bradyte/minimax/hardware/minimax.png

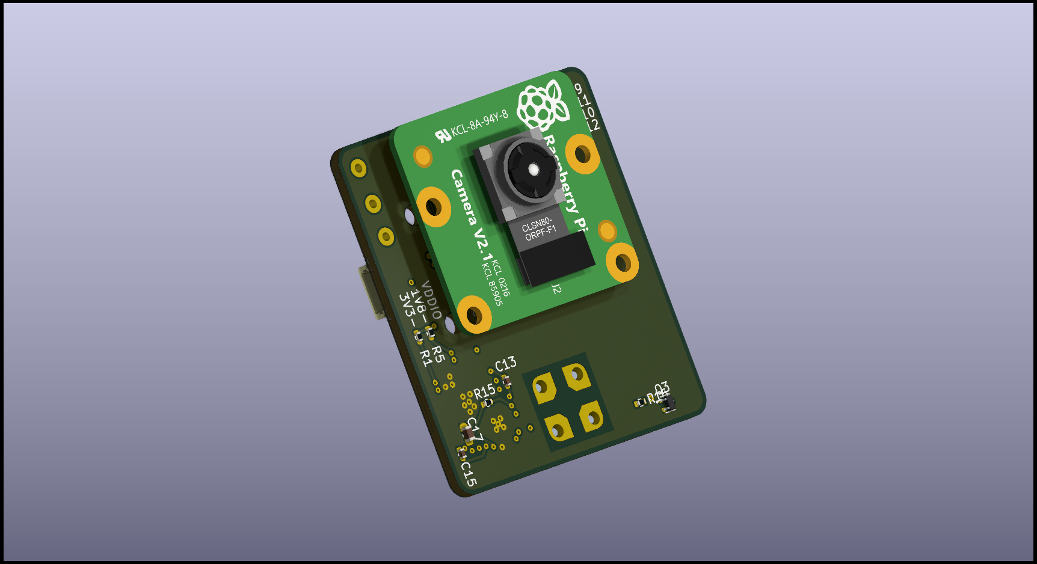
hardware/minimax.png
