bradyte/minimax/hardware/minimax-front.png

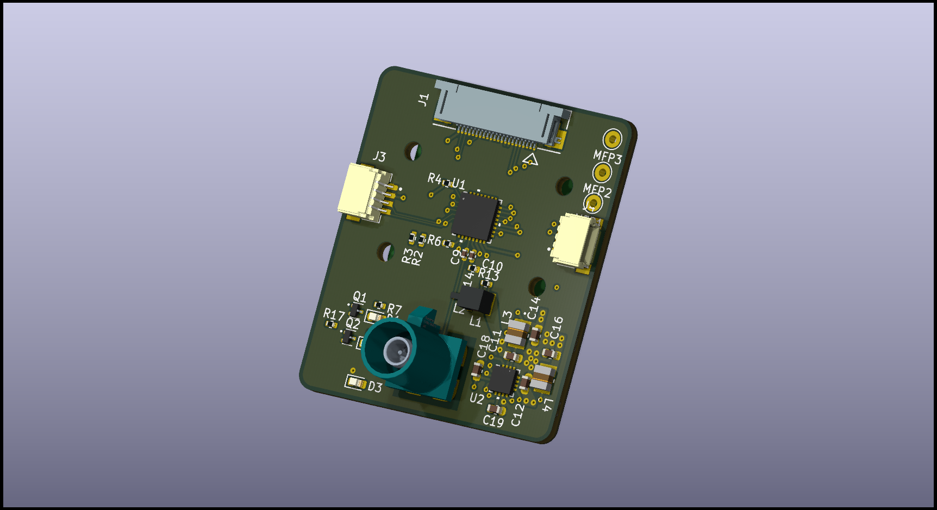
hardware/minimax-front.png
