bradyte/minimax/hardware/minimax.kicad_pcb

## KiCad design hardware/minimax.kicad_pcb (2025-03-13)

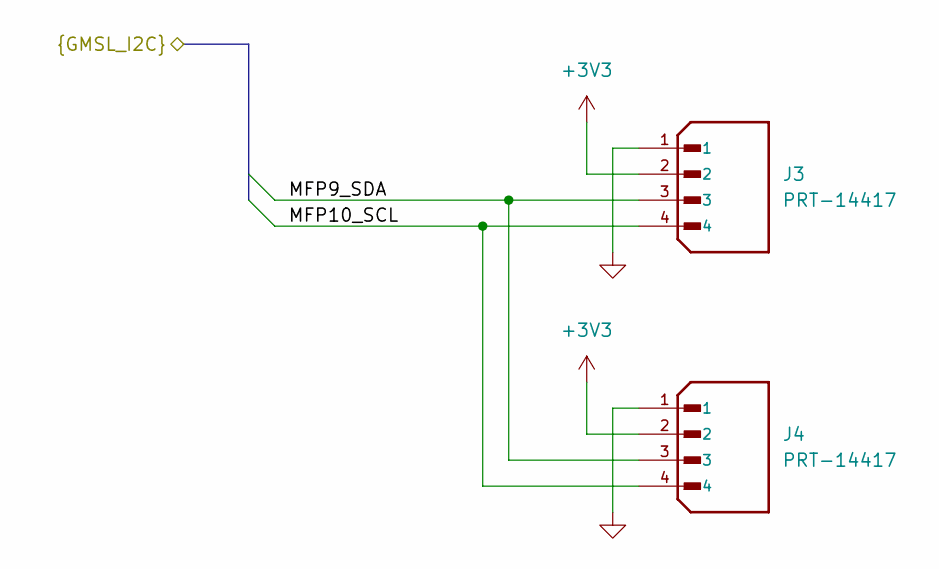
[picture p9: schematic peripherals.kicad_sch]

Parts:
J3, J4: PRT-14417; SPARKFUN_PRT-14417

Connections:
+3V3: J3.2, J4.2; also elsewhere on the board
/camera/MFP9_SDA: J3.3, J4.3; also elsewhere on the board
/camera/MFP10_SCL: J3.4, J4.4; also elsewhere on the board
GND: J3.1, J4.1; also elsewhere on the board

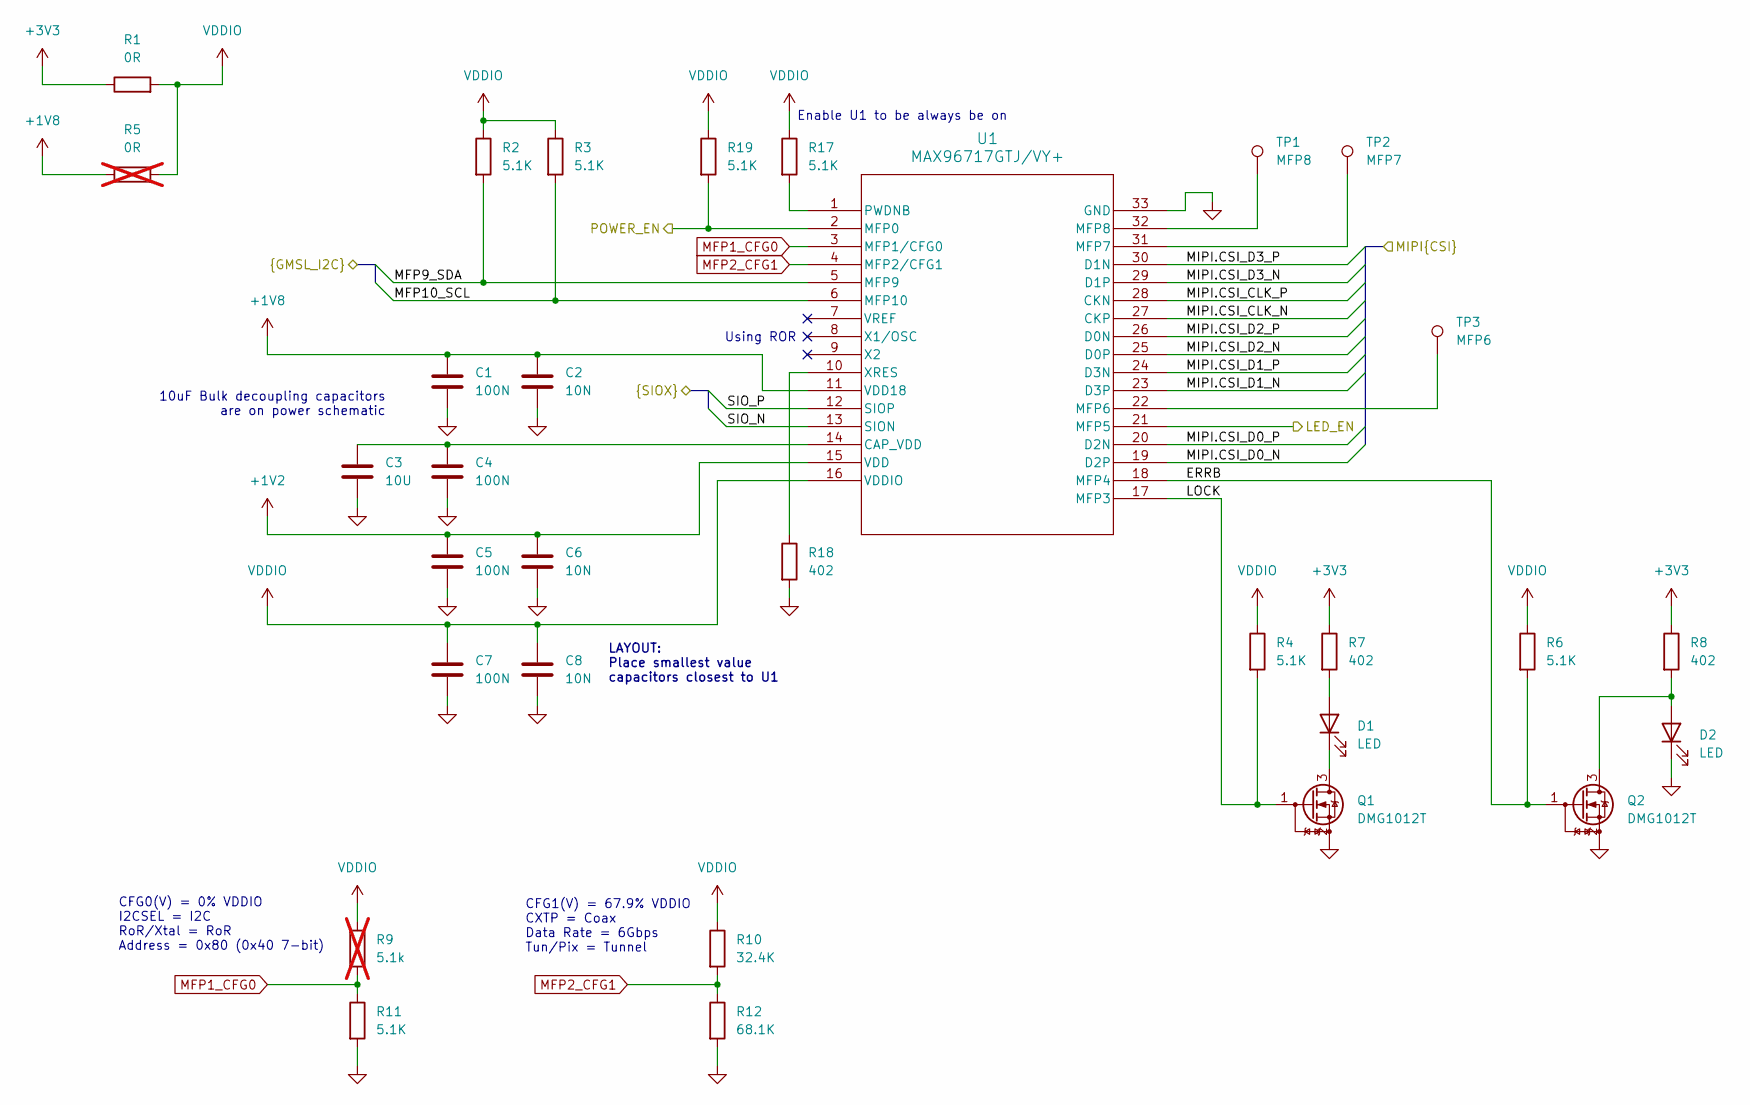
[picture p10: schematic gmsl.kicad_sch]

Parts:
C1, C4, C5, C7: 100N; C_0402_1005Metric
C2, C6, C8: 10N; C_0402_1005Metric
C3: 10U; C_0603_1608Metric
D1, D2: LED; LED_0603_1608Metric
Q1, Q2: DMG1012T; SOT-523
R1: 0R; R_0402_1005Metric
R2, R3, R4, R6, R11, R17, R19: 5.1K; R_0402_1005Metric
R5: 0R; R_0402_1005Metric; not fitted
R7, R8, R18: 402; R_0402_1005Metric
R9: 5.1k; R_0402_1005Metric; not fitted
R10: 32.4K; R_0402_1005Metric
R12: 68.1K; R_0402_1005Metric
TP1: MFP8; TestPoint_THTPad_D1.0mm_Drill0.5mm
TP2: MFP7; TestPoint_THTPad_D1.0mm_Drill0.5mm
TP3: MFP6; TestPoint_THTPad_D1.0mm_Drill0.5mm
U1: MAX96717GTJ/VY+; ADI_21-100156_T3255Y-8

Connections:
+1V2: C5.1, C6.1, U1.15 (VDD); also elsewhere on the board
+1V8: C1.1, C2.1, R5.1, U1.11 (VDD18); also elsewhere on the board
+3V3: R1.1, R7.1, R8.1; also elsewhere on the board
/camera/LED_EN: U1.21 (MFP5); also elsewhere on the board
/camera/MFP9_SDA: R2.2, U1.5 (MFP9); also elsewhere on the board
/camera/MFP10_SCL: R3.2, U1.6 (MFP10); also elsewhere on the board
/camera/MIPI.CSI_CLK_N: U1.27 (CKP); also elsewhere on the board
/camera/MIPI.CSI_CLK_P: U1.28 (CKN); also elsewhere on the board
/camera/MIPI.CSI_D0_N: U1.19 (D2P); also elsewhere on the board
/camera/MIPI.CSI_D0_P: U1.20 (D2N); also elsewhere on the board
/camera/MIPI.CSI_D1_N: U1.23 (D3P); also elsewhere on the board
/camera/MIPI.CSI_D1_P: U1.24 (D3N); also elsewhere on the board
/camera/MIPI.CSI_D2_N: U1.25 (D0P); also elsewhere on the board
/camera/MIPI.CSI_D2_P: U1.26 (D0N); also elsewhere on the board
/camera/MIPI.CSI_D3_N: U1.29 (D1P); also elsewhere on the board
/camera/MIPI.CSI_D3_P: U1.30 (D1N); also elsewhere on the board
/camera/POWER_EN: R19.2, U1.2 (MFP0); also elsewhere on the board
/connector/SIO_N: U1.13 (SION); also elsewhere on the board
/connector/SIO_P: U1.12 (SIOP); also elsewhere on the board
/gmsl/ERRB: Q2.1 (G), R6.2, U1.18 (MFP4)
/gmsl/LOCK: Q1.1 (G), R4.2, U1.17 (MFP3)
GND: C1.2, C2.2, C3.2, C4.2, C5.2, C6.2, C7.2, C8.2, D2.1 (K), Q1.2 (S), Q2.2 (S), R11.2, R12.2, R18.2, U1.33 (GND); also elsewhere on the board
MFP1_CFG0: R9.2, R11.1, U1.3 (MFP1/CFG0)
MFP2_CFG1: R10.2, R12.1, U1.4 (MFP2/CFG1)
unnamed: D1.2 (A), R7.2
unnamed: D1.1 (K), Q1.3 (D)
unnamed: D2.2 (A), Q2.3 (D), R8.2
unnamed: C3.1, C4.1, U1.14 (CAP_VDD)
unnamed: TP3.1, U1.22 (MFP6)
unnamed: TP2.1, U1.31 (MFP7)
unnamed: TP1.1, U1.32 (MFP8)
unnamed: R17.2, U1.1 (PWDNB)
unnamed: R18.1, U1.10 (XRES)
VDDIO: C7.1, C8.1, R1.2, R2.1, R3.1, R4.1, R5.2, R6.1, R9.1, R10.1, R17.1, R19.1, U1.16 (VDDIO)

Notes on the sheet:
LAYOUT: Place smallest value capacitors closest to U1
CFG0(V) = 0% VDDIO I2CSEL = I2C RoR/Xtal = RoR Address = 0x80 (0x40 7-bit)
10uF Bulk decoupling capacitors are on power schematic
Using ROR
CFG1(V) = 67.9% VDDIO CXTP = Coax Data Rate = 6Gbps Tun/Pix = Tunnel
Enable U1 to be always be on

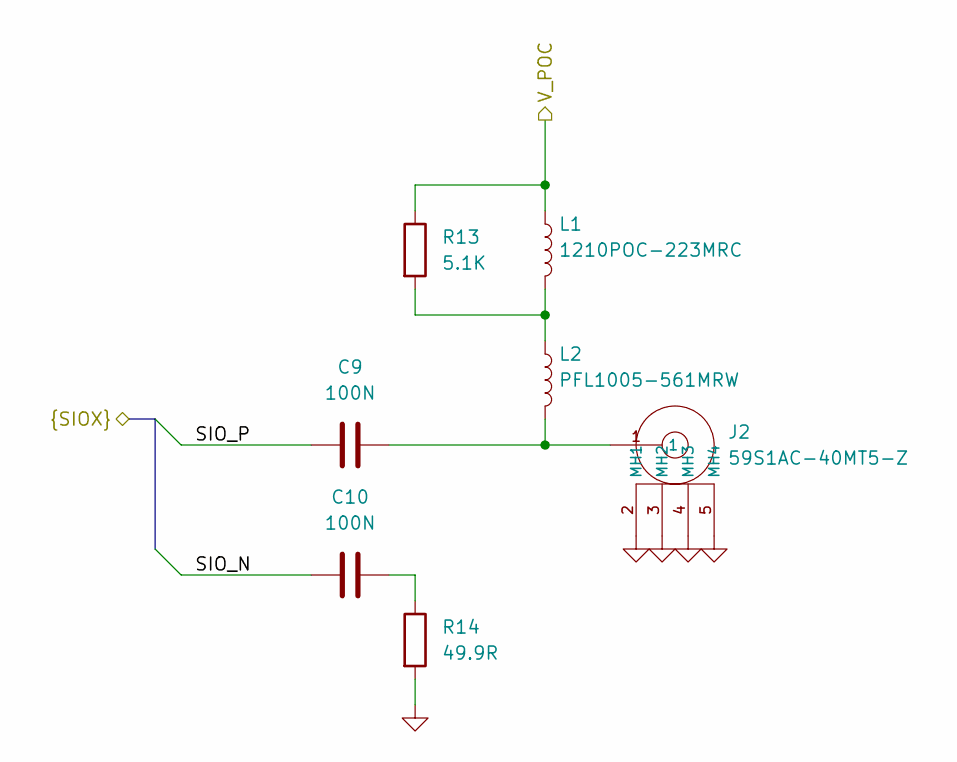
[picture p11: schematic connector.kicad_sch]

Parts:
C9, C10: 100N; C_0402_1005Metric
J2: 59S1AC-40MT5-Z
L1: 1210POC-223MRC; L_Coilcraft_1210POC
L2: PFL1005-561MRW; L_Coilcraft_PFL1005
R13: 5.1K; R_0402_1005Metric
R14: 49.9R; R_0402_1005Metric

Connections:
/connector/SIO_N: C10.1; also elsewhere on the board
/connector/SIO_P: C9.1; also elsewhere on the board
/connector/V_POC: L1.1, R13.1; also elsewhere on the board
GND: J2.2 (MH1), J2.3 (MH2), J2.4 (MH3), J2.5 (MH4), R14.2; also elsewhere on the board
unnamed: C9.2, J2.1, L2.2
unnamed: C10.2, R14.1
unnamed: L1.2, L2.1, R13.2

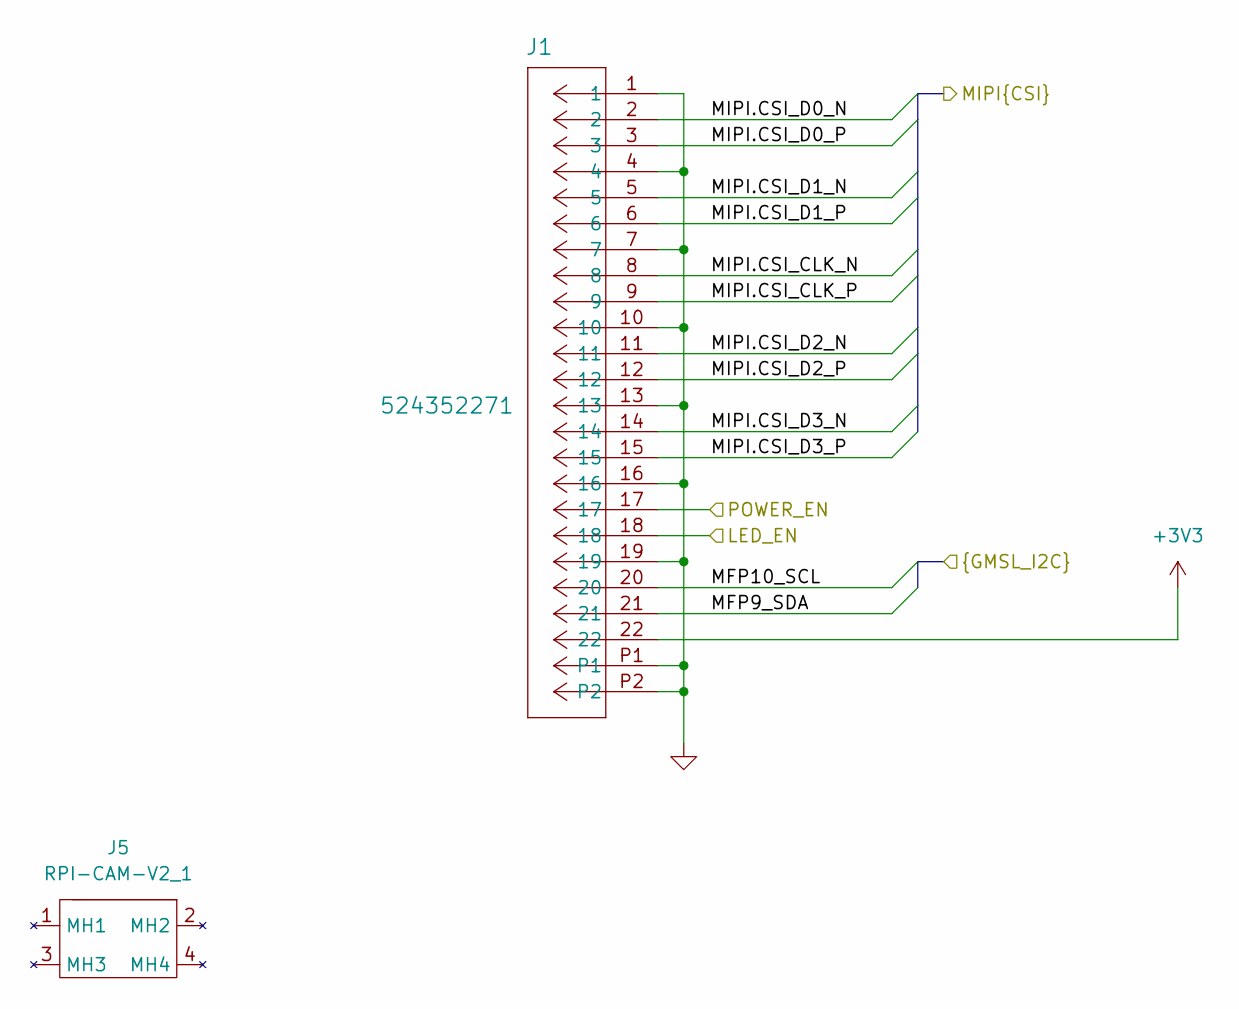
[picture p12: schematic camera.kicad_sch]

Parts:
J1: 524352271; CON_524352271_MOL
J5: RPI-CAM-V2_1

Connections:
+3V3: J1.22; also elsewhere on the board
/camera/LED_EN: J1.18; also elsewhere on the board
/camera/MFP9_SDA: J1.21; also elsewhere on the board
/camera/MFP10_SCL: J1.20; also elsewhere on the board
/camera/MIPI.CSI_CLK_N: J1.8; also elsewhere on the board
/camera/MIPI.CSI_CLK_P: J1.9; also elsewhere on the board
/camera/MIPI.CSI_D0_N: J1.2; also elsewhere on the board
/camera/MIPI.CSI_D0_P: J1.3; also elsewhere on the board
/camera/MIPI.CSI_D1_N: J1.5; also elsewhere on the board
/camera/MIPI.CSI_D1_P: J1.6; also elsewhere on the board
/camera/MIPI.CSI_D2_N: J1.11; also elsewhere on the board
/camera/MIPI.CSI_D2_P: J1.12; also elsewhere on the board
/camera/MIPI.CSI_D3_N: J1.14; also elsewhere on the board
/camera/MIPI.CSI_D3_P: J1.15; also elsewhere on the board
/camera/POWER_EN: J1.17; also elsewhere on the board
GND: J1.1, J1.4, J1.7, J1.10, J1.13, J1.16, J1.19, J1.P1, J1.P2; also elsewhere on the board

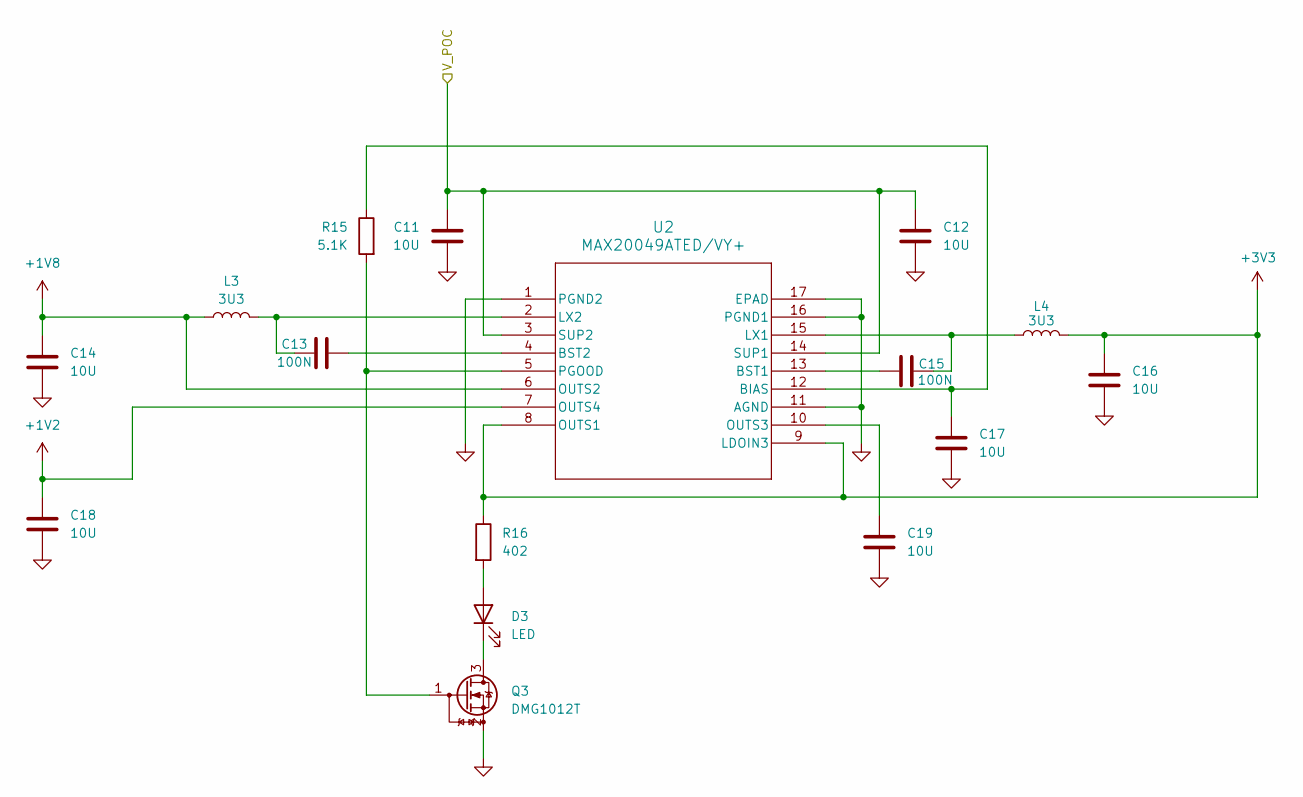
[picture p13: schematic power.kicad_sch]

Parts:
C11, C12, C14, C16, C17, C18, C19: 10U; C_0603_1608Metric
C13, C15: 100N; C_0402_1005Metric
D3: LED; LED_0603_1608Metric
L3, L4: 3U3; IND_TFM252012ALMA_TDK
Q3: DMG1012T; SOT-523
R15: 5.1K; R_0402_1005Metric
R16: 402; R_0402_1005Metric
U2: MAX20049ATED/VY+; 21-100150D_T1633Y&plus_5C_MXM

Connections:
+1V2: C18.1, U2.7 (OUTS4); also elsewhere on the board
+1V8: C14.1, L3.1, U2.6 (OUTS2); also elsewhere on the board
+3V3: C16.1, L4.1, R16.1, U2.8 (OUTS1), U2.9 (LDOIN3); also elsewhere on the board
/connector/V_POC: C11.1, C12.1, U2.3 (SUP2), U2.14 (SUP1); also elsewhere on the board
GND: C11.2, C12.2, C14.2, C16.2, C17.2, C18.2, C19.2, Q3.2 (S), U2.1 (PGND2), U2.11 (AGND), U2.16 (PGND1), U2.17 (EPAD); also elsewhere on the board
unnamed: D3.2 (A), R16.2
unnamed: D3.1 (K), Q3.3 (D)
unnamed: Q3.1 (G), R15.2, U2.5 (PGOOD)
unnamed: C17.1, R15.1, U2.12 (BIAS)
unnamed: C15.1, U2.13 (BST1)
unnamed: C13.2, U2.4 (BST2)
unnamed: C15.2, L4.2, U2.15 (LX1)
unnamed: C13.1, L3.2, U2.2 (LX2)
unnamed: C19.1, U2.10 (OUTS3)

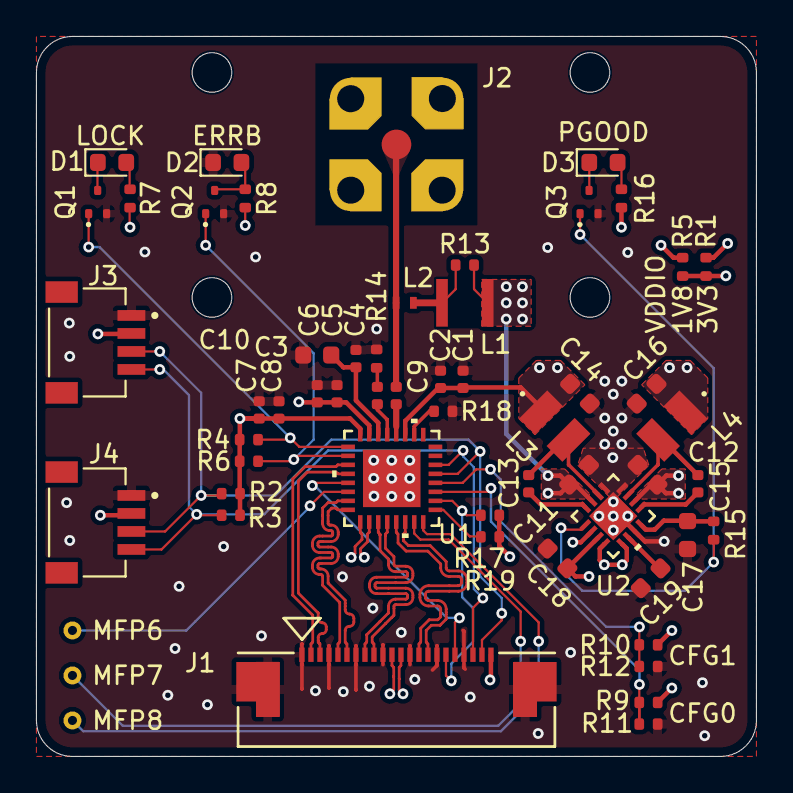
[picture p14: board minimax.kicad_pcb from above]

Board: 4 copper layers, 40.0 x 40.0 mm, 58 parts (0 on the bottom side), 47 nets.
