bradyte/minimax/(commit log)

2024-09-18 initial upload
    [minimax.kicad_pcb, minimax.kicad_sch]
2024-09-19 mipi interface land swapping
    [minimax.kicad_pcb, minimax.kicad_sch]
2024-09-23 cleaned schematics and moving to rpi v2 camera form factor
    [camera.kicad_sch, connector.kicad_sch, gmsl.kicad_sch, minimax.kicad_pcb, minimax.kicad_sch, power.kicad_sch]
2024-09-24 finished rough pass on max96717, need cfgs. added notes to imx219 inck tolerance.
    [camera.kicad_sch, connector.kicad_sch, gmsl.kicad_sch, minimax.kicad_pcb]
2024-09-24 Removed DF37 connector
    [camera.kicad_sch]
2024-09-24 added 22-pin 524352271, need to change fakra to smt
    [camera.kicad_sch, minimax.kicad_pcb]
2024-09-24 cleaned up serializer with comments and project hierarchy
    [connector.kicad_sch, gmsl.kicad_sch, minimax.kicad_sch, peripherals.kicad_sch, power.kicad_sch]
2024-09-24 cleaned up schematics
    [camera.kicad_sch, connector.kicad_sch, gmsl.kicad_sch, minimax.kicad_pcb]
2024-09-25 started power, added smt fakra
    [camera.kicad_sch, connector.kicad_sch, gmsl.kicad_sch, minimax.kicad_pcb, minimax.kicad_sch, peripherals.kicad_sch, power.kicad_sch]
2024-09-26 finished schematic, changed to 4 layer board
    [connector.kicad_sch, gmsl.kicad_sch, minimax.kicad_pcb, minimax.kicad_sch, peripherals.kicad_sch, power.kicad_sch]
2024-10-04 layout planning and decided to use bottom layer for components
    [camera.kicad_sch, connector.kicad_sch, gmsl.kicad_sch, minimax.kicad_pcb, peripherals.kicad_sch, power.kicad_sch]
2024-10-04 cleaned up power supply and started minor power plane routing
    [camera.kicad_sch, gmsl.kicad_sch, minimax.kicad_pcb, peripherals.kicad_sch, power.kicad_sch]
2024-10-05 more serializer layout, waiting to do stackup analysis
    [minimax.kicad_pcb]
2024-10-07 clean up
    [connector.kicad_sch, minimax.kicad_pcb]
2024-10-08 added LED circuits and test points on extra MFPs
    [camera.kicad_sch, connector.kicad_sch, gmsl.kicad_sch, minimax.kicad_pcb, peripherals.kicad_sch, power.kicad_sch]
2024-10-08 cleaned up fakra footprint
    [gmsl.kicad_sch, minimax.kicad_pcb, power.kicad_sch]
2024-11-26 general layout changes
    [minimax.kicad_pcb]
2024-12-03 finished schematics and layout, need final aesthetic touches
    [gmsl.kicad_sch, minimax.kicad_pcb]
2024-12-10 submitted for board fab
    [gmsl.kicad_sch, minimax.kicad_pcb]
2025-01-07 fixed LED logic and added pullup on the camera enable
    [gmsl.kicad_sch, minimax.kicad_pcb]
2025-01-08 minor layout optimizations
    [minimax.kicad_pcb]
2025-01-10 added schematic pdf
2025-03-13 prepping for fab
    [camera.kicad_sch, connector.kicad_sch, gmsl.kicad_sch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]
